comotion-makerspace/usb-switch/media/arduino_switch_breadboard.jpg

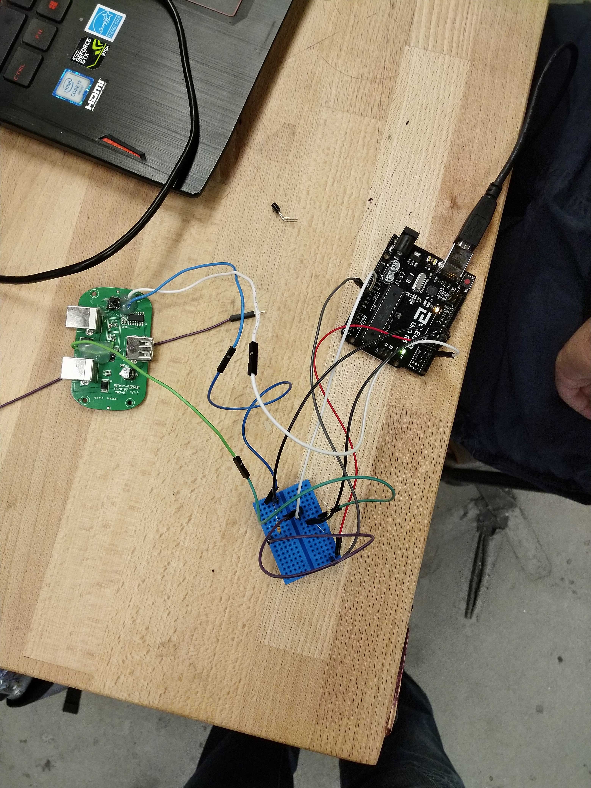
media/arduino_switch_breadboard.jpg
