comotion-makerspace/usb-switch/media/arduino_usb_switch_diagram.jpg

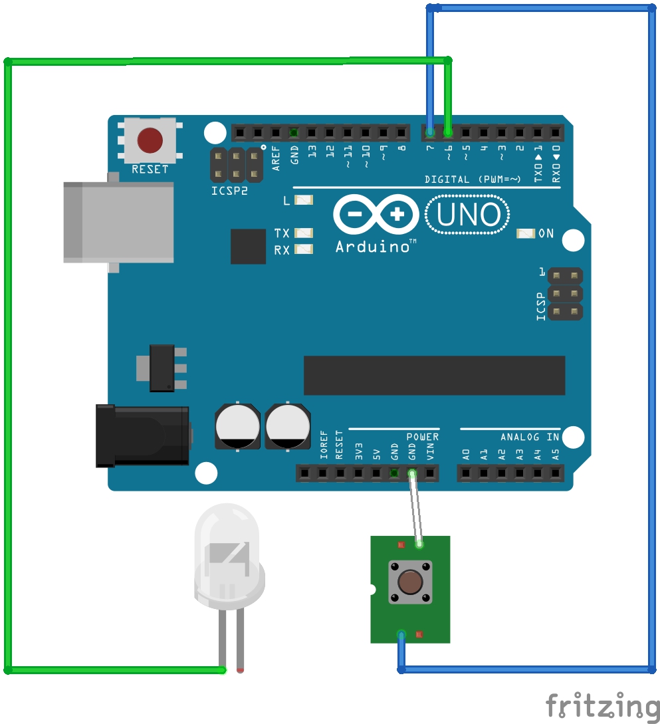
media/arduino_usb_switch_diagram.jpg
