comotion-makerspace/usb-switch/(commit log)

2019-07-30 :bento: add code sample
2019-07-30 🍱 usb bridging images
2019-07-30 📝 USB bridging hack section
2019-07-30 📝 update links
2019-07-30 🎨 formatting
